RobPo/Paperino/img/paperino-plugnplay.gif

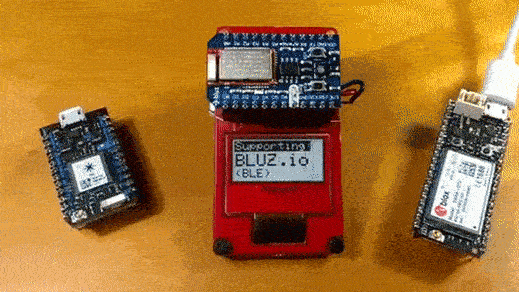
img/paperino-plugnplay.gif
