RobPo/Paperino/ism/image/slides/_u/1501873699534_41029.png

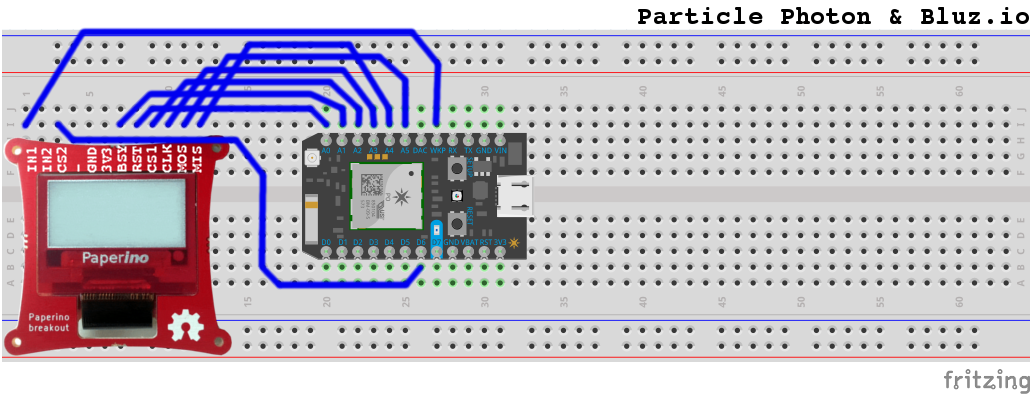
ism/image/slides/_u/1501873699534_41029.png
