RobPo/Paperino/img/DemoHelloWorld.gif

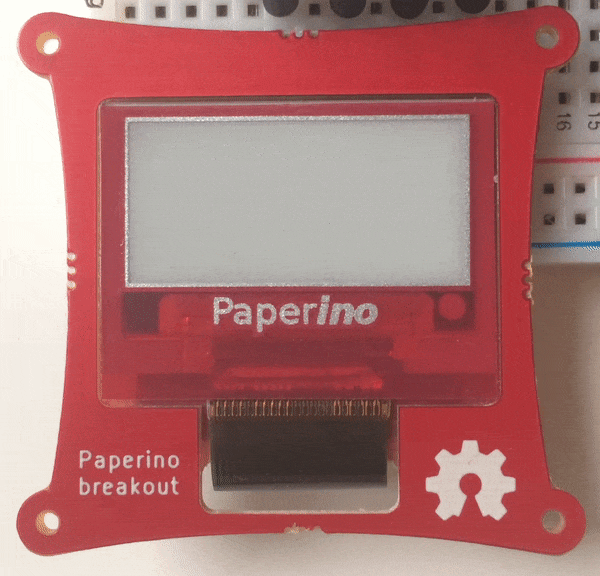
img/DemoHelloWorld.gif
