RobPo/Paperino/ism/image/slides/_u/1501873871492_330463.png

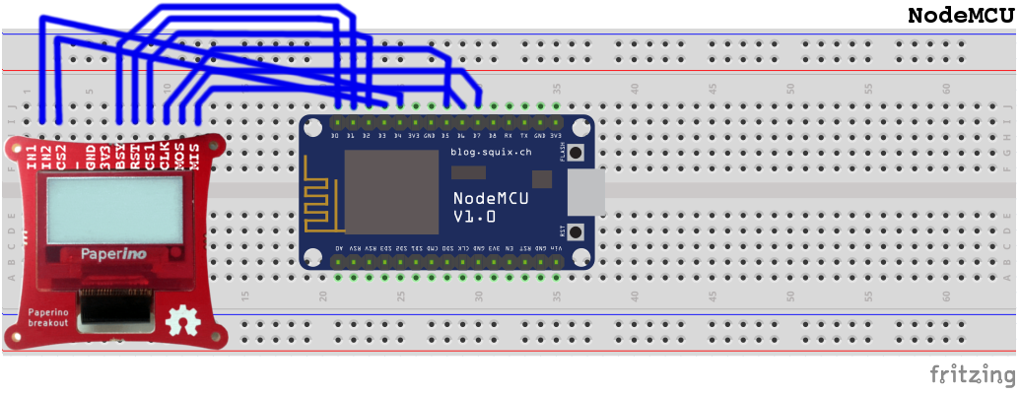
ism/image/slides/_u/1501873871492_330463.png
