RobPo/Paperino/ism/image/slides/_u/1501873873931_230986.png

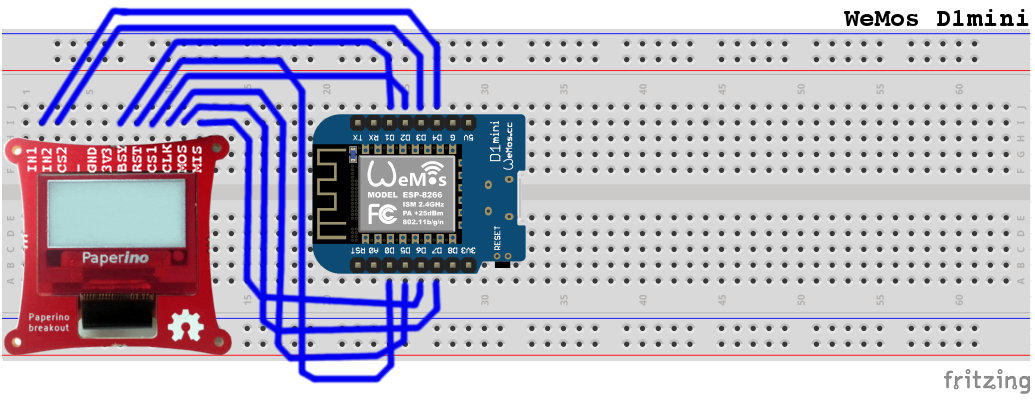
ism/image/slides/_u/1501873873931_230986.png
