RobPo/Paperino/ism/image/slides/_u/1501873874380_769519.png

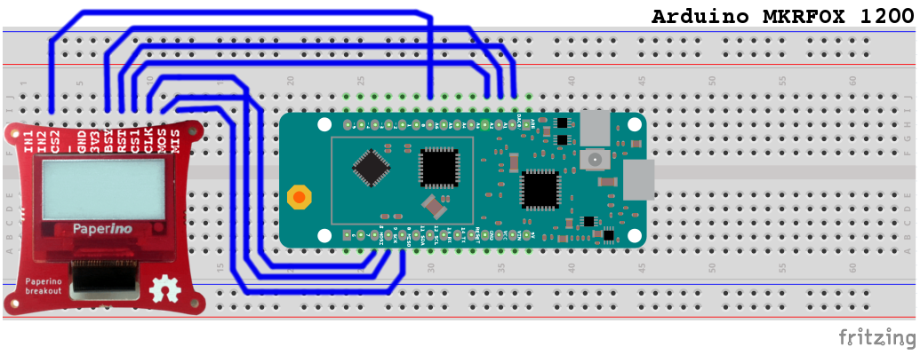
ism/image/slides/_u/1501873874380_769519.png
