RobPo/Paperino/ism/image/slides/_u/1501873874796_46246.png

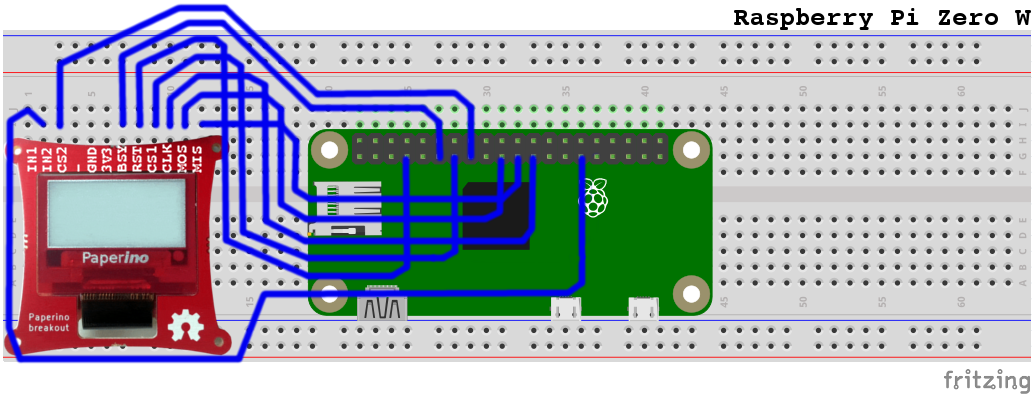
ism/image/slides/_u/1501873874796_46246.png
