RobPo/Paperino/hardware/Paperino_module/BOM/paperino BOM.xlsx

Component | Manufacturer | MPN | Schematic Reference | Qty | Value | Voltage | Material | footprint
Accelerometer | Bosch Tools | BMA250E | U1 | 1 |  |  |  | LGA-12
Diode | Fairchild Semiconductor | RB751S40 | D1, D2 | 2 |  |  |  | SOD-523F
N-Channel Mosfet | Infineon | BSS670S2LH6327XTSA1 | Q2 | 1 |  |  |  | SOT-23
P-Channel Mosfet | Diodes Inc. | DMP3099L-7 | Q1 | 1 |  |  |  | SOT-23
Inductor | Taiyo Yuden | NR4018T470M | L1 | 1 | 47µ
Connector | Omron | XF2M-2615-1A | X1 | 1
Cap 2µ2/35V | any/open |  | C3, C4 | 2 | 2µ2 | 35 | X5R | 0603
Cap 1µ/10V | any/open |  | C6, C7, C8, C9 | 4 | 1µ | 10 | X5R | 0603
Cap 0.1µ/10V | any/open |  | C1, C2, C5 | 3 | 100n | 10 | X7R | 0603
