RobPo/Paperino/hardware/Paperino_breakout/paperino_breakout.pdf

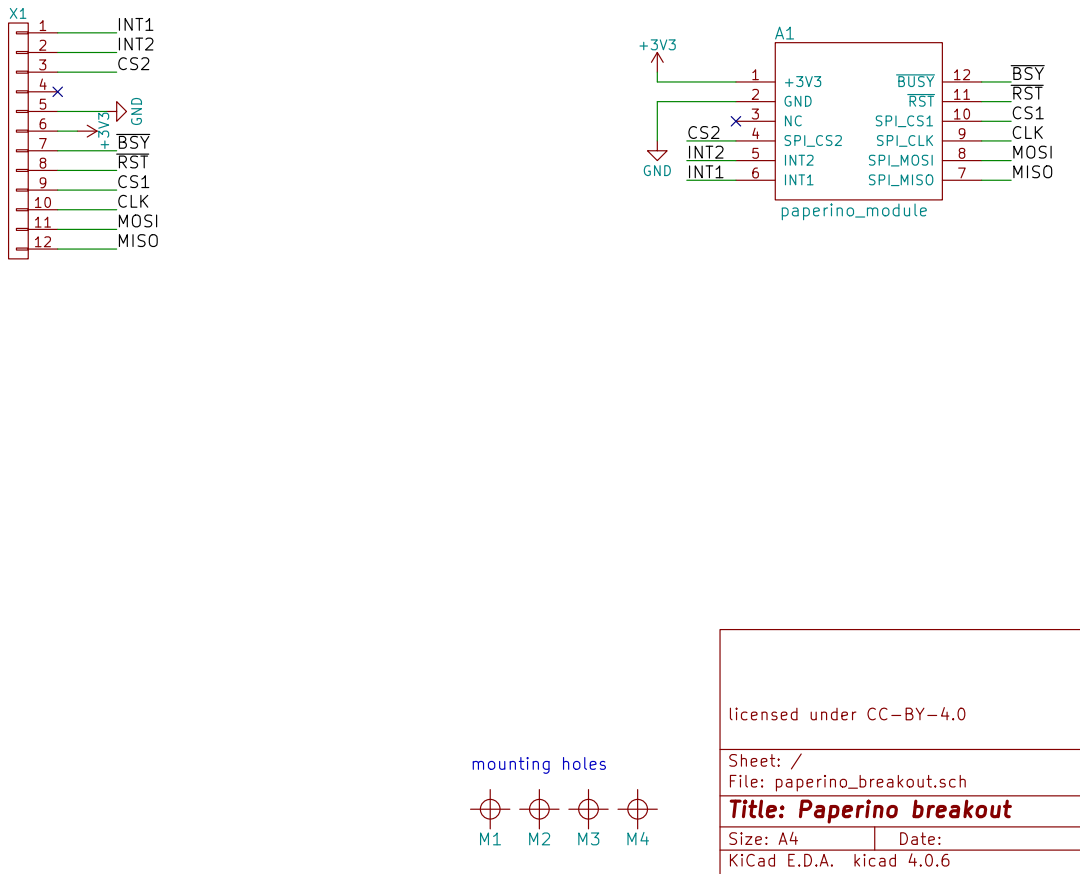
[picture p8: page 1]

licensed under CC-BY-4.0

File: paperino_breakout.sch Sheet: /
Id: 1/1 Title: Paperino breakout
