RobPo/Paperino/hardware/Paperino_module/paperino_module.pdf

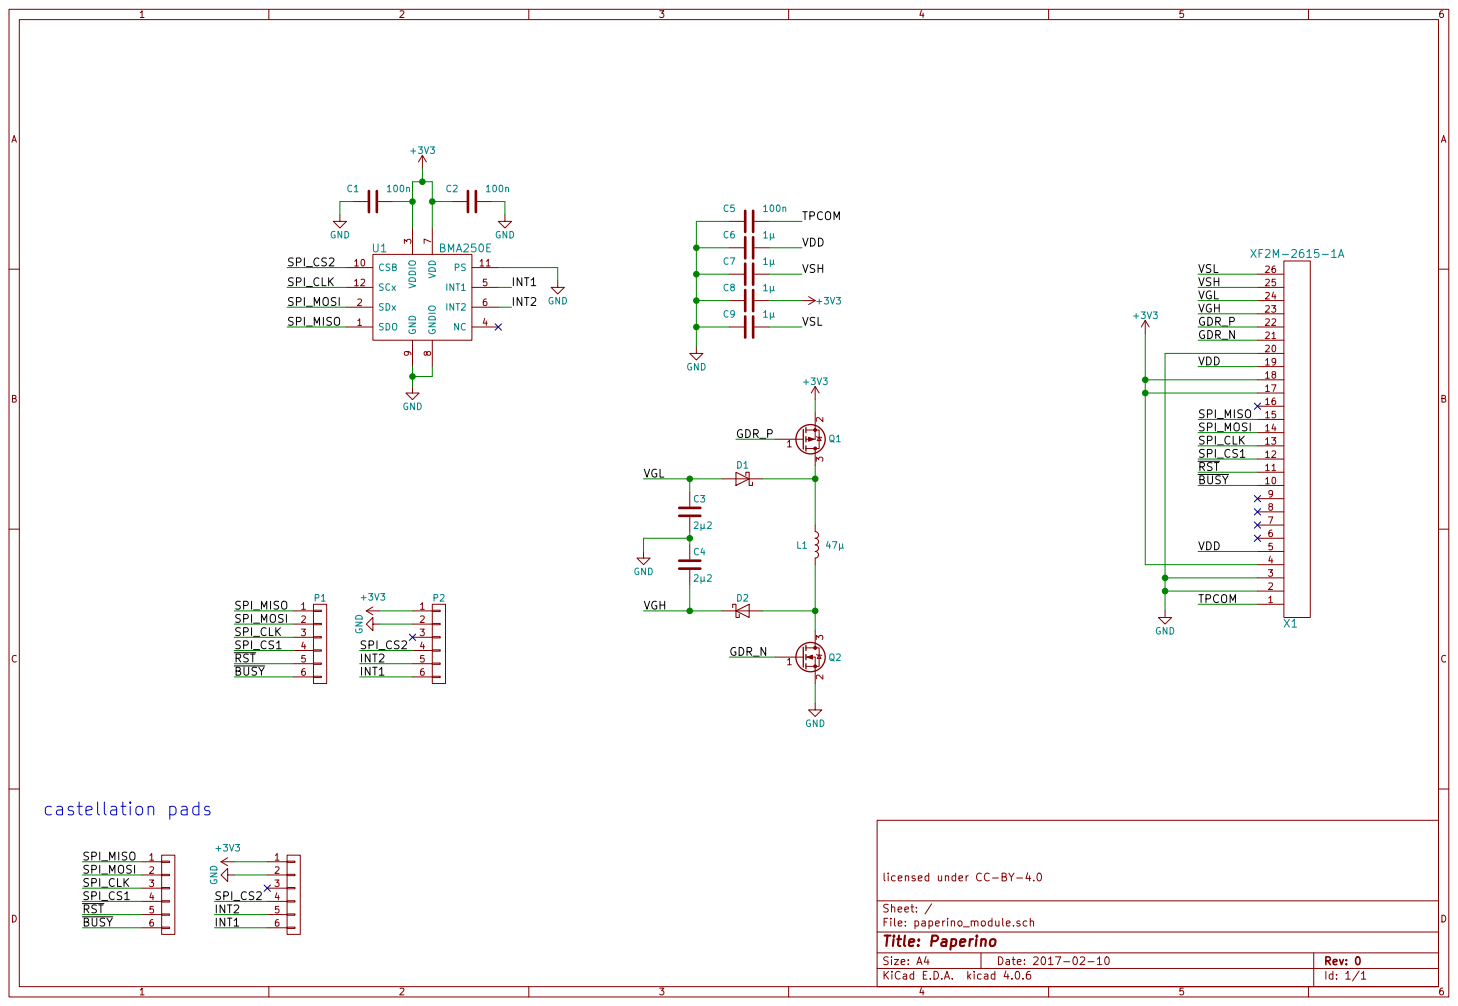
[picture p9: page 1]

16 SPI_MISO

TPCOM 1

3 | 3 SPI_CS2

licensed under CC-BY-4.0
