RobPo/Paperino/hardware/Paperino_shield/Paperino_shield.pdf

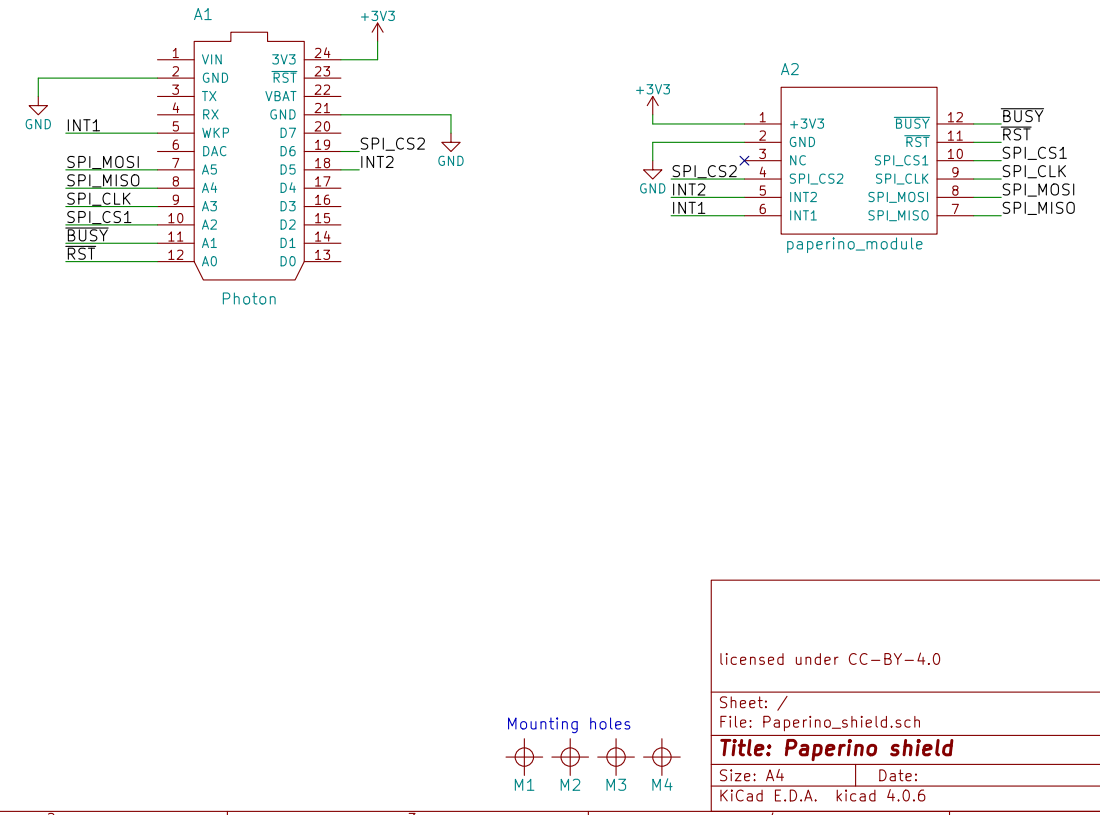
[picture p10: page 1]

licensed under CC-BY-4.0

File: Paperino_shield.sch Sheet: /
Id: 1/1 Title: Paperino shield
