RobPo/Paperino/hardware/test_rig/paperino_test_rig.pdf

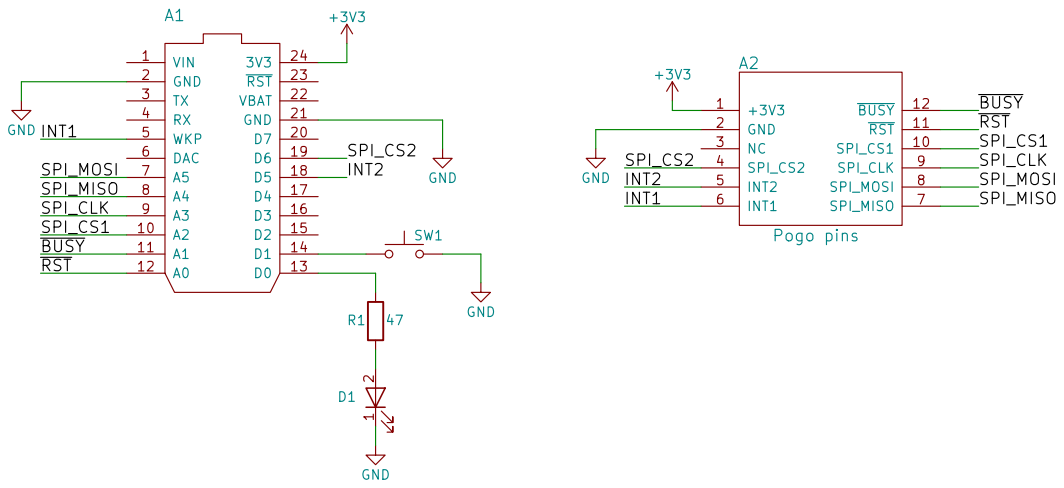
[picture p11: page 1]

licensed under CC-BY-4.0

File: paperino_test_rig.sch Sheet: /
Id: 1/1 Title: Paperino Test Rig
