RobPo/Paperino/(threads)

Thread 2 (2017-03-06):

Random startup problems during initialisation

RexBosworth, 2017-03-06:
display sometimes does not update, unplugging and restarting usually helps

RobPo, 2017-03-07:
I think this has to do with the busy pin during the ic driver initialisation; which can be undefined during the hardware reset ... the function waitForBusyIncative() then waits eternally. Lets try the new code lines. If it's OK then it will flow in the upcoming release and we can close the issue...

RobPo, 2017-03-07:
Btw, display not updating is not good!

RobPo, 2017-03-08:
Should be fixed with recent update (using pull request next time).

Closed 2017-03-08.

Thread 3 (2017-03-08):

First image update after power off starting with undefined frame buffer

RobPo, 2017-03-08:
For updating, the ePaper waveform also needs to know the actual image content in order to chose the correct waveform transition. This is handled by the driver IC, but not working for the very first image update after power cycling. Although the driven image looks more or less OK the media is driven imbalanced and the overall contrast id degraded. Workaround is to first drive an (invisible) nullframe update after each initialisation.

Thread 5 (2017-03-15):

Enable & verify support for Raspberry Pi Zero W

RobPo, 2017-03-15:
In theory this should work out of the box based on Particles RasPi implementation. Let's check that.

RobPo, 2017-07-27:
Yes this is working via Particle Raspi BETA launcher; SPISettings not support yet. Need to document wiring next.

RobPo, 2017-08-09:
Wiring documented in hookup guide. Close that for now.

Closed 2017-08-09.

Thread 9 (2018-01-23):

Questions: Simplified wiring

kratz00, 2018-01-23:
I have two questions regarding the optional simplified wiring.

1. What are the pros and cons of that approach?
Obviously one pro is that you will have two GPIO pins for other purposes. So maybe the real question is:
Are there any downsides using the simplified wiring?

2. It is currently not documented in the [Hookup Guide](https://robpo.github.io/Paperino/#1-hardware-hookup). Which probably would also be a great place to answer my first question.

RobPo, 2018-01-30:
Yes there is a disadvantage for the simplified wiring: The communication process with the driver IC is slower, because rather than sensing the "busy" line and continuing with the communication as soon as the busy line is not active anymore, there are some fix waiting delays set for the busy periods. So the image updates are slightly slower and less responsive... Its also likely to be more failure-prone to rely on the timing alone. So generally I would rather recommend to use the standard setup.
I will add a note in the hook-up guide.

Closed 2018-02-08.

Thread 14 (2019-04-03):

Compile error in Arduino IDE

molecule, 2019-04-03:
Arduino IDE version: 1.6.12
Library version: 1.1.2 (also tried 1.1.0)

Here are the errors:

In file included from /Users/molecule/Documents/Arduino/libraries/PL_microEPD/examples/_01_HelloWorld/_01_HelloWorld.ino:11:0:
/Users/molecule/Documents/Arduino/libraries/PL_microEPD/src/PL_microEPD.h:84:43: error: overflow in constant expression
     byte buffer[EPD_WIDTH * EPD_HEIGHT / 4];
                                           ^
/Users/molecule/Documents/Arduino/libraries/PL_microEPD/src/PL_microEPD.h:84:43: error: size of array 'buffer' is negative
/Users/molecule/Documents/Arduino/libraries/PL_microEPD/src/PL_microEPD.h:85:44: error: overflow in constant expression
     byte buffer2[EPD_WIDTH * EPD_HEIGHT / 4];
                                            ^
/Users/molecule/Documents/Arduino/libraries/PL_microEPD/src/PL_microEPD.h:85:44: error: size of array 'buffer2' is negative
exit status 1
Error compiling for board Arduino Pro or Pro Mini.

I can fix this but wanted to ping the authors about their thoughts before I go in and make changes to the library.

aymanbagabas, 2020-06-21:
I'm getting this compile error too, did you manage to fix it?

sail2themoon, 2023-10-28:
Same for me with library from Paperino source. Did someone solved this?
